bschulz1701/LEAF/Documentation/LEAF_v2_BlockDiagrams.pptx

Rain Gauge

Pulse

Counter

BME280

Anemometer

Pulse

Counter

I2C/Serial

Accelerometer

Particle

Sap Flux

Analog

I2C

Stream Depth

Amp

Serial

PAR

Analog

OneWire

Stream Temp

Amp

I2C/Analog

Radiometer

Analog

Amp

## Slide 2

Solar

MPPT

Battery

Power Monitor

Particle

Vin

3.3v

Switch

Sensors
3v3

5.0v

Switch

DC/DC

Heater
PWM

Sensors
5v
