bschulz1701/LEAF/Documentation/LEAF_v2_BlockDiagrams.pdf

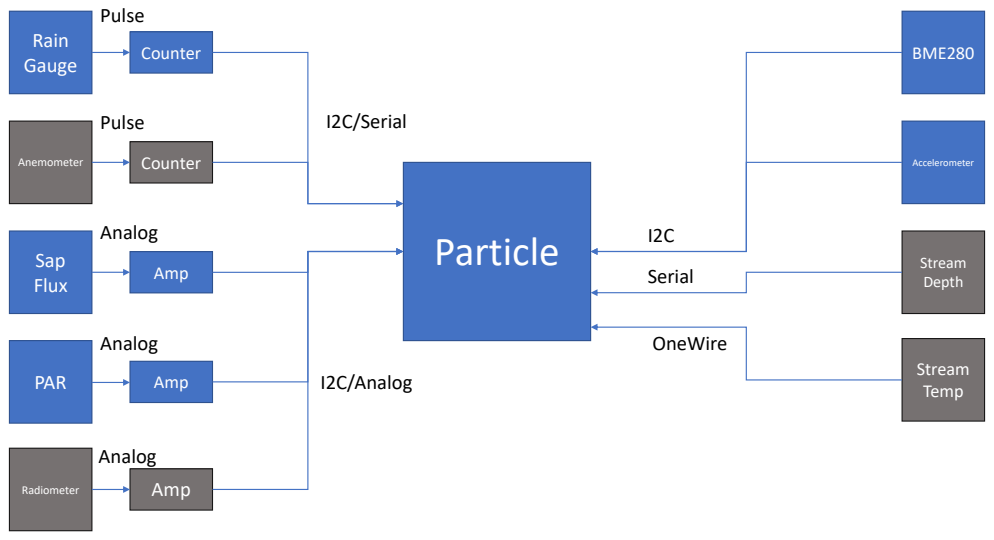
[picture p1: page 1]
Particle; Rain; Gauge; Counter; Anemometer; Sap; Flux; Amp; PAR; Radiometer; BME280; Accelerometer; Stream Depth; Stream Temp; Pulse; Analog; I2C/Analog; I2C/Serial; Serial; OneWire

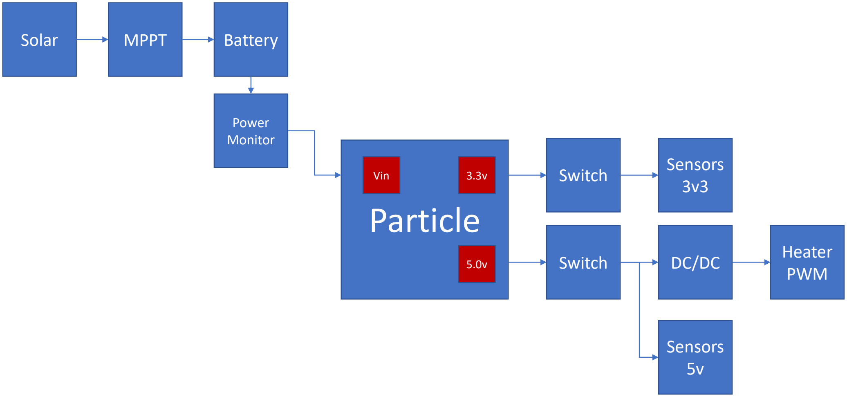
[picture p2: figure]
Particle; Vin; Solar; MPPT; Battery; Switch; Heater PWM; Sensors 5v; Sensors 3v3; Power Monitor
