bschulz1701/LEAF/Hardware/CoreLogger_TopLoadMicro.brd

## EAGLE design Hardware/CoreLogger_TopLoadMicro.brd (2019-05-06)

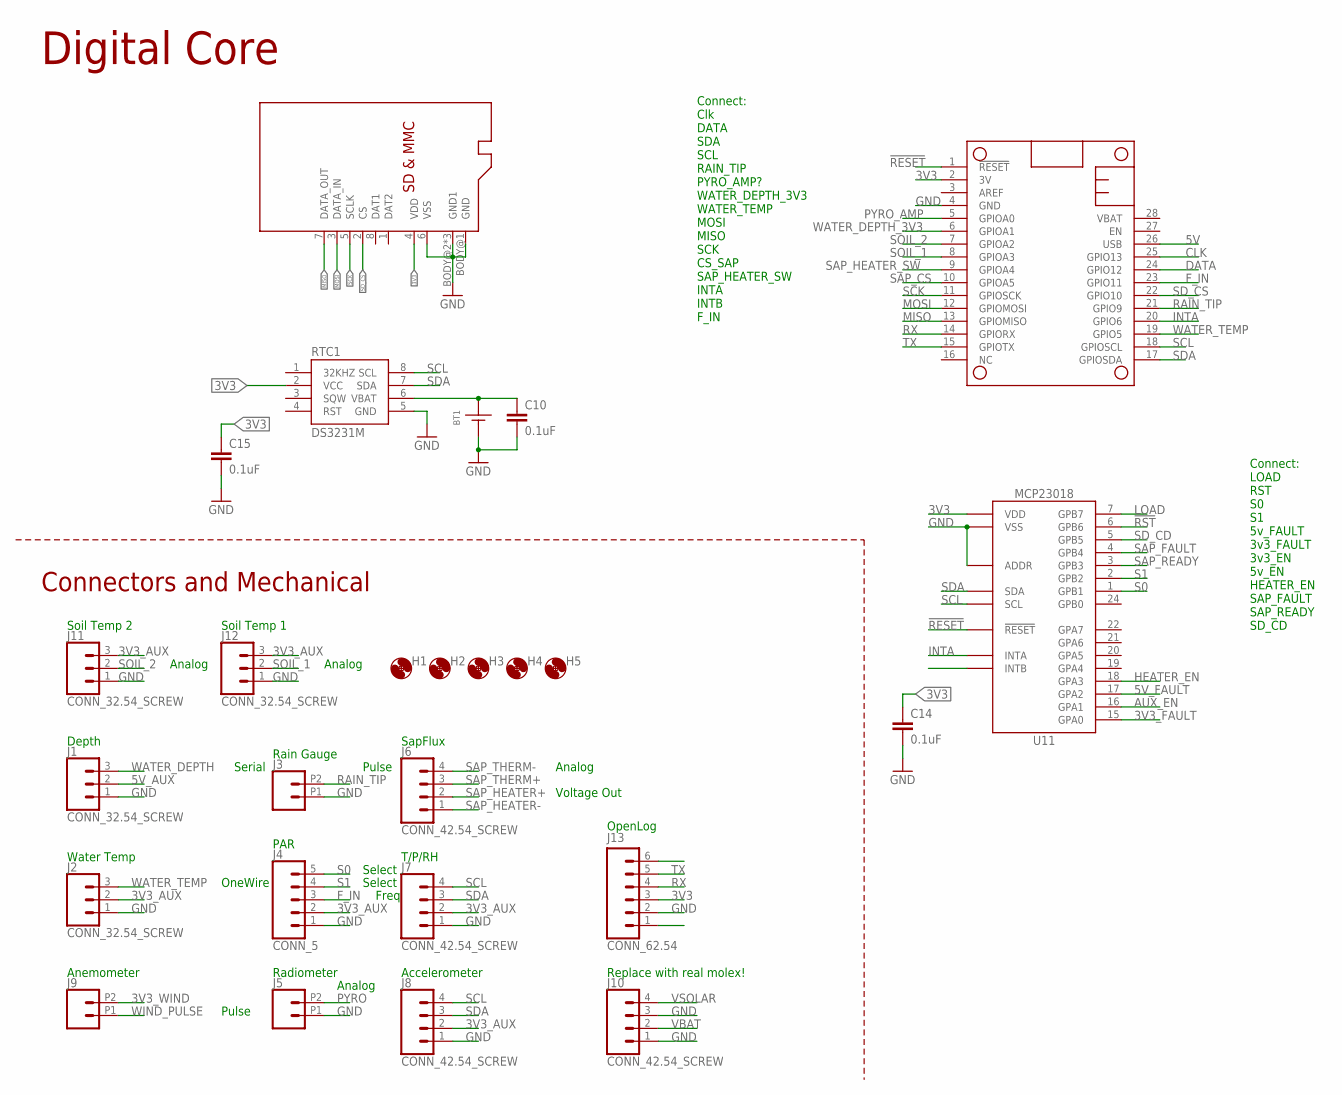
[picture p3: schematic CoreLogger_TopLoadMicro.sch, sheet 1]

Parts:
BT1: BATTERY_COIN12MM; LINX_BAT-HLD-012-SMT
C10: 0.1uF; C0603
C14, C15: 0.1uF; C0402
H1, H2, H3, H4, H5: MOUNTING_HOLE4_NP; 4_40
J1, J2, J11, J12: CONN_32.54_SCREW; 1X03_SCREW
J3, J5, J9: CONN_022.54_SCREW; 1X02_2.54_SCREWTERM
J4: CONN_5; 1X05
J6, J7, J8, J10: CONN_42.54_SCREW; 1X04_SCREW
J13: CONN_62.54; 1X06
MS1: FEATHERWING_NODIM; FEATHERWING_DIM
RTC1: DS3231M; SO08
SD1: MICROSD_NOCDHINDGED; USD_MOLEX_HINDGED
U11: MCP23018QFN; QFN24

Connections:
3V3: C14.1, C15.1, J13.3, MS1.2 (3V), RTC1.2 (VCC), SD1.4 (VDD), U11.8 (VDD); also elsewhere on the board
3V3_AUX: J2.2, J4.2, J7.2, J8.2, J11.3, J12.3; also elsewhere on the board
3V3_FAULT: U11.15 (GPA0); also elsewhere on the board
3V3_WIND: J9.P2 (2); also elsewhere on the board
5V: MS1.26 (USB); also elsewhere on the board
5V_AUX: J1.2; also elsewhere on the board
5V_FAULT: U11.17 (GPA2); also elsewhere on the board
!RESET: MS1.1 (!RESET), U11.12 (!RESET)
!RST: U11.6 (GPB6); also elsewhere on the board
AUX_EN: U11.16 (GPA1); also elsewhere on the board
CLK: MS1.25 (GPIO13); also elsewhere on the board
DATA: MS1.24 (GPIO12); also elsewhere on the board
F_IN: J4.3, MS1.23 (GPIO11)
GND: BT1.GND (-), C10.2, C14.2, C15.2, J1.1, J2.1, J3.P1 (1), J4.1, J5.P1 (1), J7.1, J8.1, J10.1, J10.3, J11.1, J12.1, J13.2, MS1.4 (GND), RTC1.5 (GND), SD1.6 (VSS), SD1.BODY@1 (GND), SD1.BODY@2 (GND1), SD1.BODY@3 (GND1), SD1.BODY@4 (GND1), U11.11 (ADDR), U11.23 (VSS); also elsewhere on the board
HEATER_EN: U11.18 (GPA3); also elsewhere on the board
INTA: MS1.20 (GPIO6), U11.14 (INTA)
LOAD: U11.7 (GPB7); also elsewhere on the board
MISO: MS1.13 (GPIOMISO), SD1.7 (DATA_OUT); also elsewhere on the board
MOSI: MS1.12 (GPIOMOSI), SD1.3 (DATA_IN); also elsewhere on the board
unnamed: BT1.POWER0 (+), BT1.POWER1 (+), C10.1, RTC1.6 (VBAT)
PYRO: J5.P2 (2); also elsewhere on the board
PYRO_AMP: MS1.5 (GPIOA0); also elsewhere on the board
RAIN_TIP: J3.P2 (2), MS1.21 (GPIO9); also elsewhere on the board
RX: J13.4, MS1.14 (GPIORX)
S0: J4.5, U11.1 (GPB1)
S1: J4.4, U11.2 (GPB2)
SAP_CS: MS1.10 (GPIOA5); also elsewhere on the board
SAP_FAULT: U11.4 (GPB4); also elsewhere on the board
SAP_HEATER+: J6.2; also elsewhere on the board
SAP_HEATER-: J6.1; also elsewhere on the board
SAP_HEATER_SW: MS1.9 (GPIOA4); also elsewhere on the board
SAP_READY: U11.3 (GPB3); also elsewhere on the board
SAP_THERM+: J6.3; also elsewhere on the board
SAP_THERM-: J6.4; also elsewhere on the board
SCK: MS1.11 (GPIOSCK), SD1.5 (SCLK); also elsewhere on the board
SCL: J7.4, J8.4, MS1.18 (GPIOSCL), RTC1.8 (SCL), U11.9 (SCL); also elsewhere on the board
SDA: J7.3, J8.3, MS1.17 (GPIOSDA), RTC1.7 (SDA), U11.10 (SDA); also elsewhere on the board
SD_CD: U11.5 (GPB5)
SD_CS: MS1.22 (GPIO10), SD1.2 (CS)
SOIL_1: J12.2, MS1.8 (GPIOA3)
SOIL_2: J11.2, MS1.7 (GPIOA2)
TX: J13.5, MS1.15 (GPIOTX)
VBAT: J10.2; also elsewhere on the board
VSOLAR: J10.4; also elsewhere on the board
WATER_DEPTH: J1.3; also elsewhere on the board
WATER_DEPTH_3V3: MS1.6 (GPIOA1); also elsewhere on the board
WATER_TEMP: J2.3, MS1.19 (GPIO5); also elsewhere on the board
WIND_PULSE: J9.P1 (1); also elsewhere on the board

Notes on the sheet:
Depth
Water Temp
Radiometer
PAR
Rain Gauge
Accelerometer
T/P/RH
SapFlux
OneWire
Serial
Pulse
Freq
Select
Analog
Voltage Out
Anemometer
Replace with real molex!
Connect: Clk DATA SDA SCL RAIN_TIP PYRO_AMP? WATER_DEPTH_3V3 WATER_TEMP MOSI MISO SCK CS_SAP SAP_HEATER_SW INTA INTB F_IN
Connect: LOAD RST S0 S1 5v_FAULT 3v3_FAULT 3v3_EN 5v_EN HEATER_EN SAP_FAULT SAP_READY SD_CD
Digital Core
Connectors and Mechanical
Soil Temp 2
Soil Temp 1
OpenLog

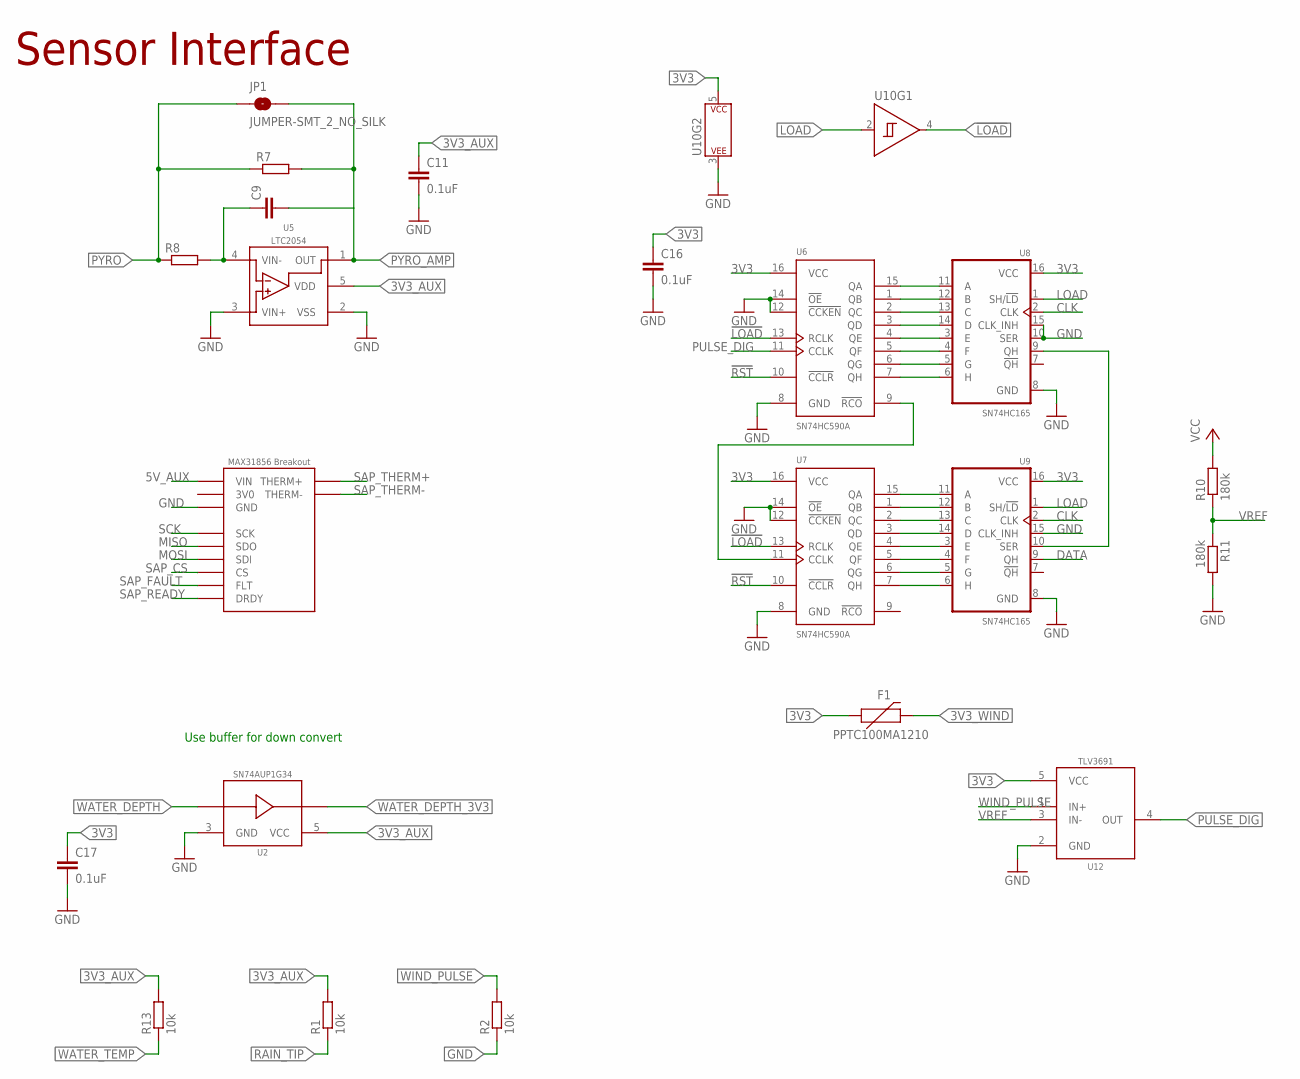
[picture p4: schematic CoreLogger_TopLoadMicro.sch, sheet 2]

Parts:
C9: C-EU1NFC0603; C0603
C11, C16, C17: 0.1uF; C0402
F1: PPTC100MA1210; 1210_BOURNS
JP1: JUMPER-SMT_2_NO_SILK; SMT-JUMPER_2_NO_SILK
R1, R2, R13: 10k; R0603
R7: R-EU_P27KR0603; R0603
R8: R-EU_1KR0603; R0603
R10, R11: 180k; R0603
U2: SN74AUP1G34SC70; DCK_R-PDSO-G5
U5: LTC2054; SOT23-5
U6, U7: SN74HC590AD; SO16
U8, U9: SN74HC165D; SO16
U10: SN74AUP1G14DCK; DCK_R-PDSO-G5
U12: TLV3691DCK; DCK_R-PDSO-G5
XU1: MAX31856_BREAKOUT

Connections:
3V0: XU1.3VO (3V0)
3V3: C16.1, C17.1, F1.1, R10.2, U6.16 (VCC), U7.16 (VCC), U8.16 (VCC), U9.16 (VCC), U10.5 (P$V+), U12.5 (VCC); also elsewhere on the board
3V3_AUX: C11.1, R1.2, R13.2, U2.5 (VCC), U5.5 (VDD); also elsewhere on the board
3V3_WIND: F1.2; also elsewhere on the board
5V_AUX: XU1.VIN; also elsewhere on the board
!LOAD: U6.13 (RCLK), U7.13 (RCLK), U10.4 (Y)
!RST: U6.10 (!CCLR), U7.10 (!CCLR); also elsewhere on the board
CLK: U8.2 (CLK), U9.2 (CLK); also elsewhere on the board
DATA: U9.9 (QH); also elsewhere on the board
GND: C11.2, C16.2, C17.2, R2.1, R11.2, U2.3 (GND), U5.2 (VSS), U5.3 (VIN+), U6.8 (GND), U6.12 (!CCKEN), U6.14 (!OE), U7.8 (GND), U7.12 (!CCKEN), U7.14 (!OE), U8.8 (GND), U8.10 (SER), U8.15 (CLK_INH), U9.8 (GND), U9.15 (CLK_INH), U10.3 (P$V-), U12.2 (GND), XU1.GND; also elsewhere on the board
LOAD: U8.1 (SH/!LD), U9.1 (SH/!LD), U10.2 (A); also elsewhere on the board
MISO: XU1.SDO; also elsewhere on the board
MOSI: XU1.SDI; also elsewhere on the board
unnamed: C9.1, R8.2, U5.4 (VIN-)
unnamed: U7.15 (QA), U9.11 (A)
unnamed: U7.1 (QB), U9.12 (B)
unnamed: U7.2 (QC), U9.13 (C)
unnamed: U7.3 (QD), U9.14 (D)
unnamed: U7.4 (QE), U9.3 (E)
unnamed: U7.5 (QF), U9.4 (F)
unnamed: U7.6 (QG), U9.5 (G)
unnamed: U7.7 (QH), U9.6 (H)
unnamed: U6.7 (QH), U8.6 (H)
unnamed: U6.6 (QG), U8.5 (G)
unnamed: U6.5 (QF), U8.4 (F)
unnamed: U6.4 (QE), U8.3 (E)
unnamed: U6.3 (QD), U8.14 (D)
unnamed: U6.2 (QC), U8.13 (C)
unnamed: U6.1 (QB), U8.12 (B)
unnamed: U6.15 (QA), U8.11 (A)
unnamed: U8.9 (QH), U9.10 (SER)
unnamed: U6.9 (!RCO), U7.11 (CCLK)
PULSE_DIG: U6.11 (CCLK), U12.4 (OUT)
PYRO: JP1.1, R7.1, R8.1; also elsewhere on the board
PYRO_AMP: C9.2, JP1.2, R7.2, U5.1 (OUT); also elsewhere on the board
RAIN_TIP: R1.1; also elsewhere on the board
SAP_CS: XU1.CS; also elsewhere on the board
SAP_FAULT: XU1.FLT; also elsewhere on the board
SAP_READY: XU1.DRDY; also elsewhere on the board
SAP_THERM+: XU1.THERM+; also elsewhere on the board
SAP_THERM-: XU1.THERM-; also elsewhere on the board
SCK: XU1.SCK; also elsewhere on the board
VREF: R10.1, R11.1, U12.3 (IN-)
WATER_DEPTH: U2.2 (A); also elsewhere on the board
WATER_DEPTH_3V3: U2.4 (Y); also elsewhere on the board
WATER_TEMP: R13.1; also elsewhere on the board
WIND_PULSE: R2.2, U12.1 (IN+); also elsewhere on the board

Notes on the sheet:
Use buffer for down convert
Sensor Interface

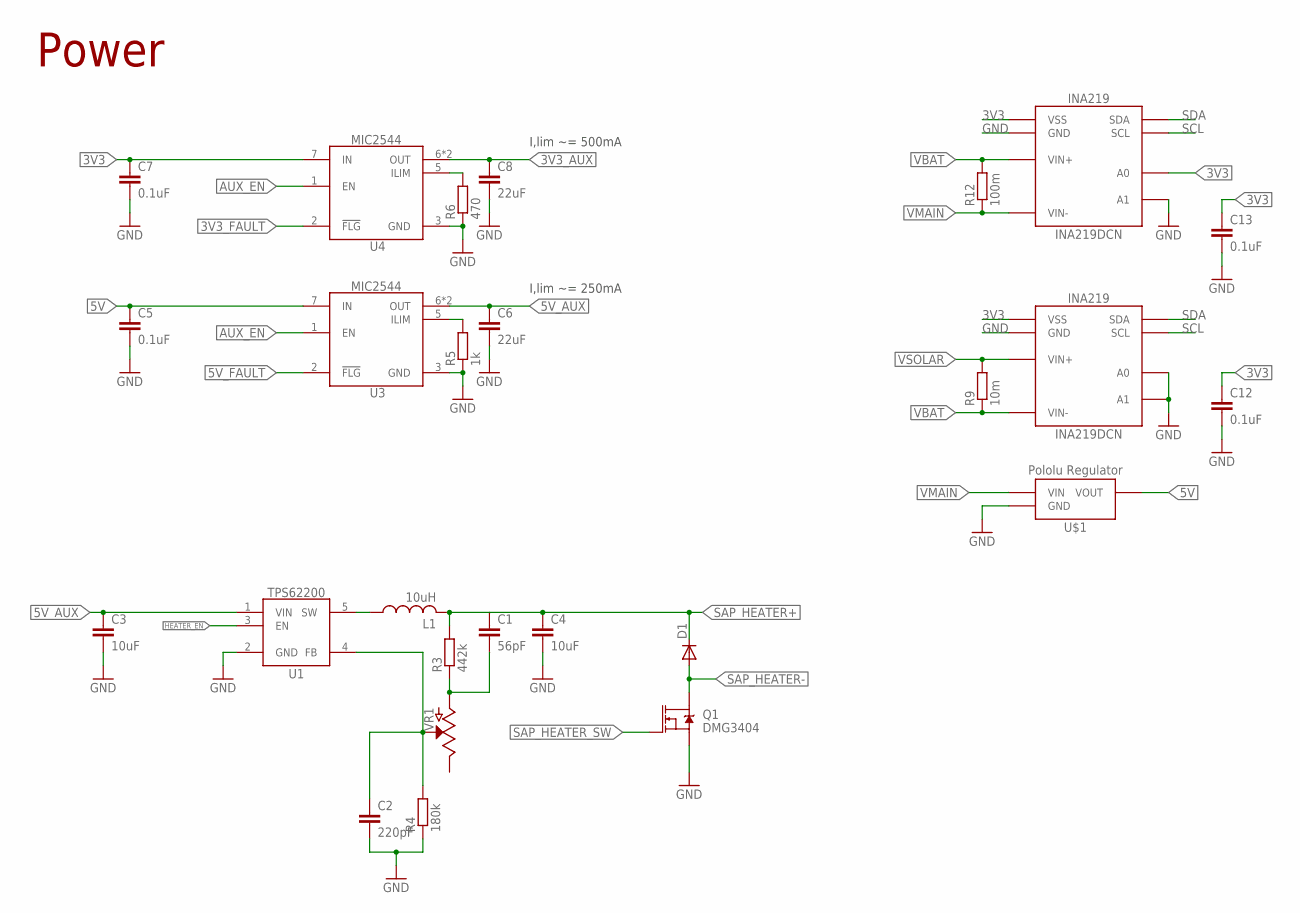
[picture p5: schematic CoreLogger_TopLoadMicro.sch, sheet 3]

Parts:
C1: 56pF; C0402
C2: 220pF; C0402
C3, C4: 10uF; C0805
C5, C7, C12, C13: 0.1uF; C0402
C6, C8: 22uF; C0805
D1: DIODESOD-123; SOD-123; MPN 1N4448W-TP; DIGIKEY 1N4448WTPMSCT-ND
L1: 10uH; WE-LQS(4X4); MPN 74404043100A; DIGIKEY 732-10757-1-ND
Q1: DMG3404; SOT23-3
R3: 442k; R0603
R4: 180k; R0603
R5: 1k; R0603
R6: 470; R0603
R9: 10m; R0805
R12: 100m; R0805
U1: TPS62200SOT23; DBV0005A
U3, U4: MIC2544MSOP; MSOP_8
U13, U14: INA219DCN; DCN_R-PDSO-G8
U$1: POLOLU_REGULATOR; U1V10FX_REGULATOR
VR1: POTENTIOMETER3214W; POT_3214W; MPN 3214W-1-204E; DIGIKEY 3214W-1-204ECT-ND

Connections:
3V3: C7.1, C12.1, C13.1, U4.7 (IN), U13.4 (VSS), U14.4 (VSS), U14.7 (A0); also elsewhere on the board
3V3_AUX: C8.1, U4.6 (OUT), U4.8 (OUT); also elsewhere on the board
3V3_FAULT: U4.2 (!FLG); also elsewhere on the board
5V: C5.1, U3.7 (IN), U$1.VOUT; also elsewhere on the board
5V_AUX: C3.1, C6.1, U1.1 (VIN), U3.6 (OUT), U3.8 (OUT); also elsewhere on the board
5V_FAULT: U3.2 (!FLG); also elsewhere on the board
AUX_EN: U3.1 (EN), U4.1 (EN); also elsewhere on the board
GND: C2.2, C3.2, C4.2, C5.2, C6.2, C7.2, C8.2, C12.2, C13.2, Q1.2 (S), R4.1, R5.1, R6.1, U1.2 (GND), U3.3 (GND), U4.3 (GND), U13.3 (GND), U13.7 (A0), U13.8 (A1), U14.3 (GND), U14.8 (A1), U$1.GND; also elsewhere on the board
HEATER_EN: U1.3 (EN); also elsewhere on the board
unnamed: C1.2, R3.1, VR1.1 (A)
unnamed: C2.1, R4.2, U1.4 (FB), VR1.2 (S)
unnamed: R6.2, U4.5 (ILIM)
unnamed: R5.2, U3.5 (ILIM)
unnamed: L1.P$1 (1), U1.5 (SW)
SAP_HEATER+: C1.1, C4.1, D1.CAT (C), L1.P$2 (2), R3.2; also elsewhere on the board
SAP_HEATER-: D1.ANODE (A), Q1.3 (D); also elsewhere on the board
SAP_HEATER_SW: Q1.1 (G); also elsewhere on the board
SCL: U13.5 (SCL), U14.5 (SCL); also elsewhere on the board
SDA: U13.6 (SDA), U14.6 (SDA); also elsewhere on the board
VBAT: R9.1, R12.2, U13.2 (VIN-), U14.1 (VIN+); also elsewhere on the board
VMAIN: R12.1, U14.2 (VIN-), U$1.VIN
VSOLAR: R9.2, U13.1 (VIN+); also elsewhere on the board

Notes on the sheet:
Power
I,lim ~= 500mA
I,lim ~= 250mA

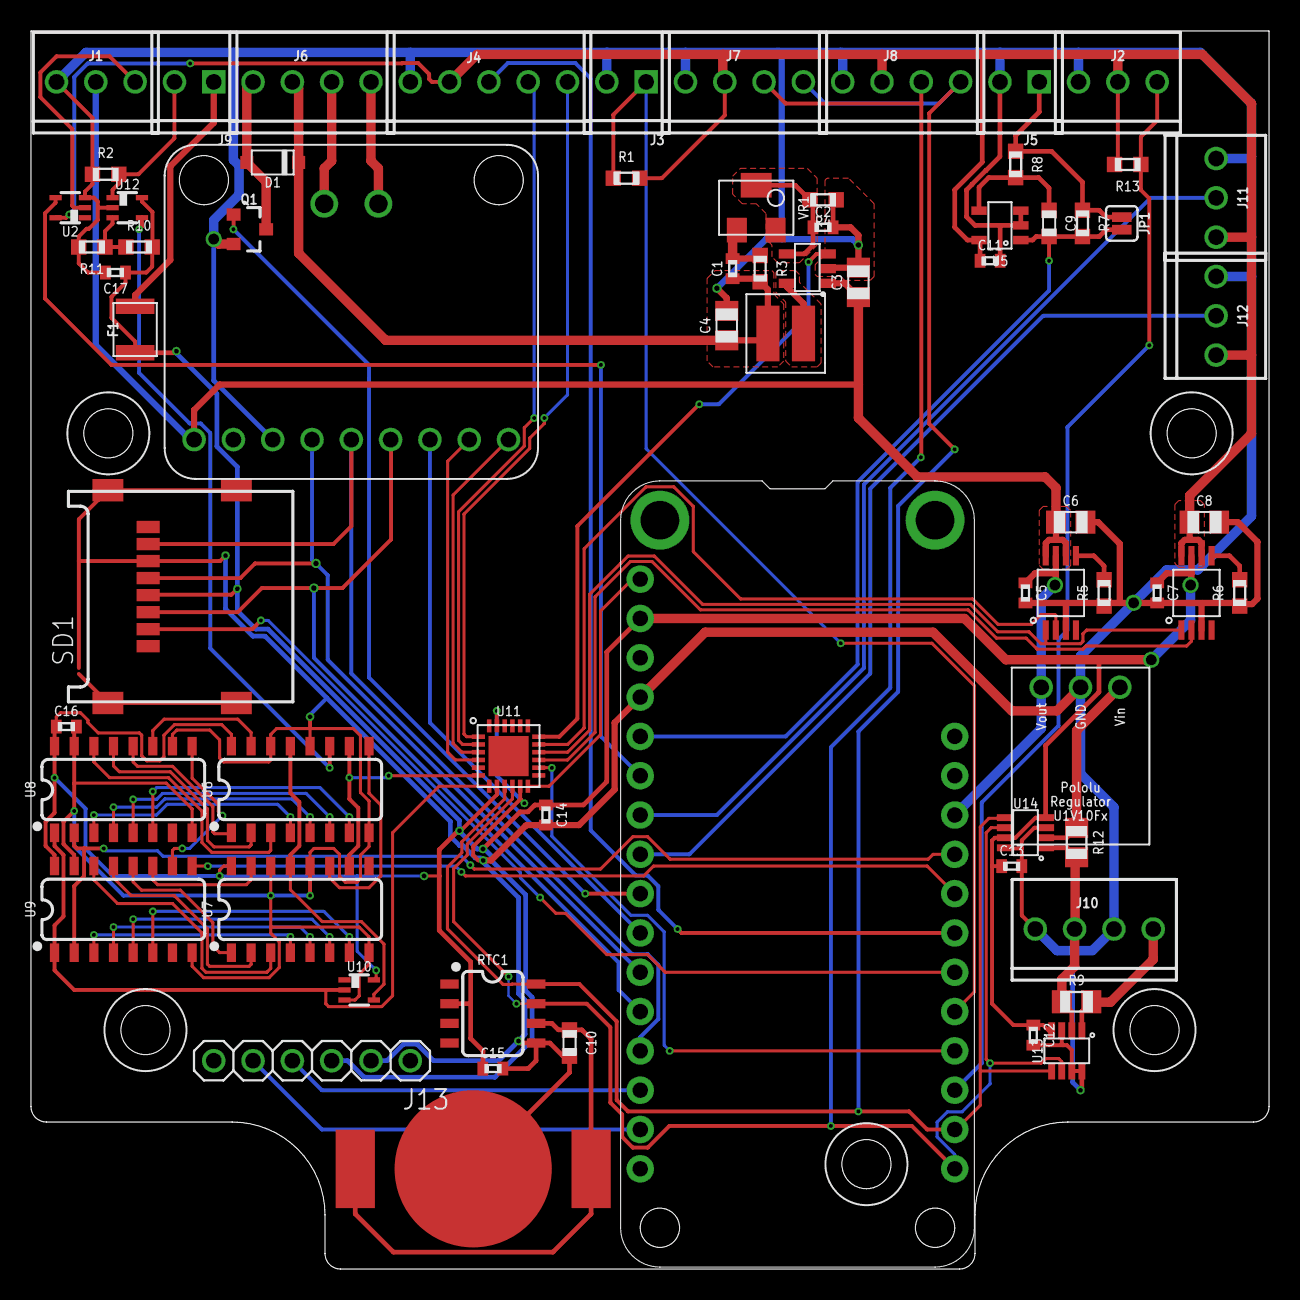
[picture p6: board CoreLogger_TopLoadMicro.brd from above]

Board: 2 copper layers, 80.0 x 80.0 mm, 74 parts (0 on the bottom side), 75 nets.
