bschulz1701/LEAF/Hardware/SolarTest/SolarMonitor_Pro.brd

## EAGLE design Hardware/SolarTest/SolarMonitor_Pro.brd (2019-03-21)

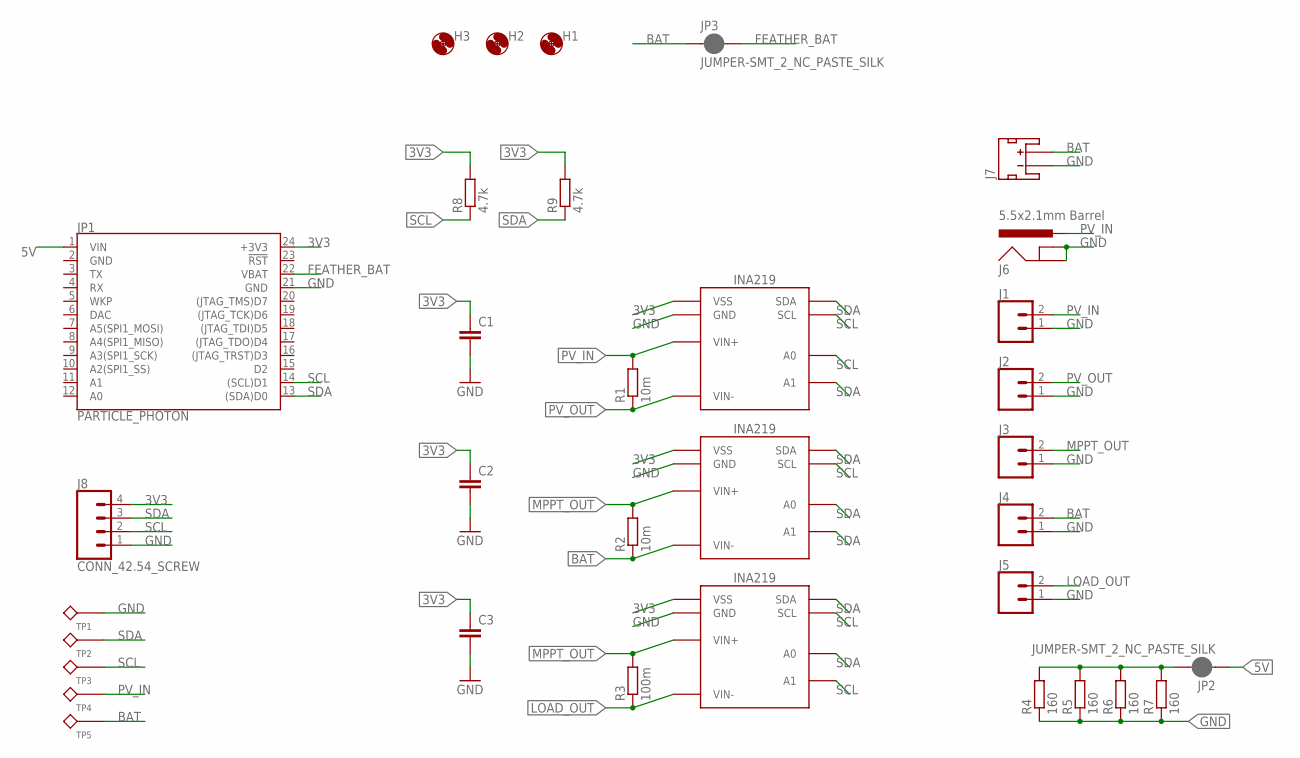
[picture p7: schematic SolarMonitor_Pro.sch]

Parts:
C1, C2, C3: C-EU0.1UFC0402; C0402
H1, H2, H3: MOUNTING_HOLE4_NP; 4_40
J1, J2, J3, J4, J5: CONN_023.5MM; SCREWTERMINAL-3.5MM-2
J6: 5.5x2.1mm Barrel; POWER_JACK_SMD
J7: JST_2MM_MALE; JST-2-SMD
J8: CONN_42.54_SCREW; 1X04_SCREW
JP1: PARTICLE_PHOTON
JP2, JP3: JUMPER-SMT_2_NC_PASTE_SILK; SMT-JUMPER_2_NC_PASTE_SILK
R1, R2: 10m; R0805
R3: 100m; R0805
R4, R5, R6, R7: 160; R1206
R8, R9: 4.7k; R0402
TP1, TP2, TP3, TP4, TP5: TESTPOINTRCU; TESTPOINT_0603
U1, U2, U3: INA219DCN; DCN_R-PDSO-G8

Connections:
3V3: C1.1, C2.1, C3.1, J8.4, JP1.24 (+3V3), R8.2, R9.2, U1.4 (VSS), U2.4 (VSS), U3.4 (VSS)
5V: JP1.1 (VIN), JP2.1
BAT: J4.2, J7.2 (+), JP3.1, R2.1, TP5.1, U2.2 (VIN-)
FEATHER_BAT: JP1.22 (VBAT), JP3.2
GND: C1.2, C2.2, C3.2, J1.1, J2.1, J3.1, J4.1, J5.1, J6.GND (GNDBREAK), J6.P$4 (GND), J7.1 (-), J8.1, JP1.2 (GND), JP1.21 (GND), R4.1, R5.1, R6.1, R7.1, TP1.1, U1.3 (GND), U2.3 (GND), U3.3 (GND)
LOAD: JP2.2, R4.2, R5.2, R6.2, R7.2
LOAD_OUT: J5.2, R3.1, U3.2 (VIN-)
MPPT_OUT: J3.2, R2.2, R3.2, U2.1 (VIN+), U3.1 (VIN+)
PV_IN: J1.2, J6.VIN0 (PWR), R1.2, TP4.1, U1.1 (VIN+)
PV_OUT: J2.2, R1.1, U1.2 (VIN-)
SCL: J8.2, JP1.14 ((SCL)D1), R8.1, TP3.1, U1.5 (SCL), U1.7 (A0), U2.5 (SCL), U3.5 (SCL), U3.8 (A1)
SDA: J8.3, JP1.13 ((SDA)D0), R9.1, TP2.1, U1.6 (SDA), U1.8 (A1), U2.6 (SDA), U2.7 (A0), U2.8 (A1), U3.6 (SDA), U3.7 (A0)

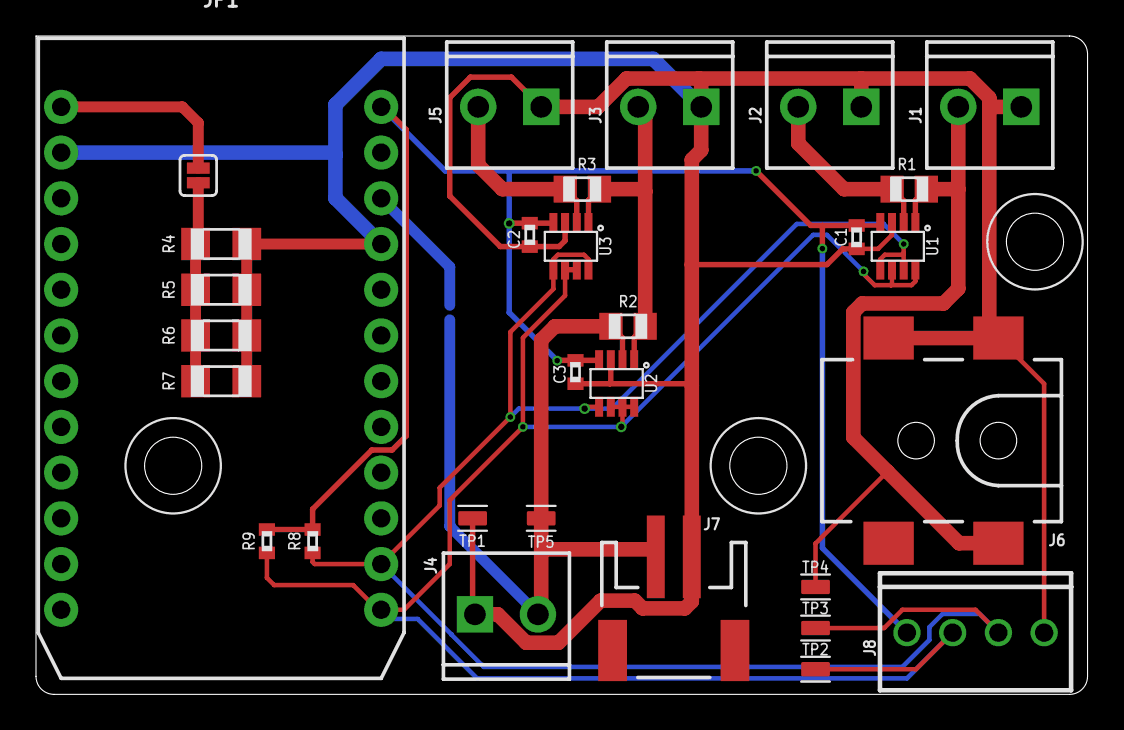
[picture p8: board SolarMonitor_Pro.brd from above]

Board: 2 copper layers, 58.4 x 36.6 mm, 34 parts (1 on the bottom side), 12 nets.
