bschulz1701/LEAF/Hardware/SolarTest/SolarMonitor.brd

## EAGLE design Hardware/SolarTest/SolarMonitor.brd (2019-03-18)

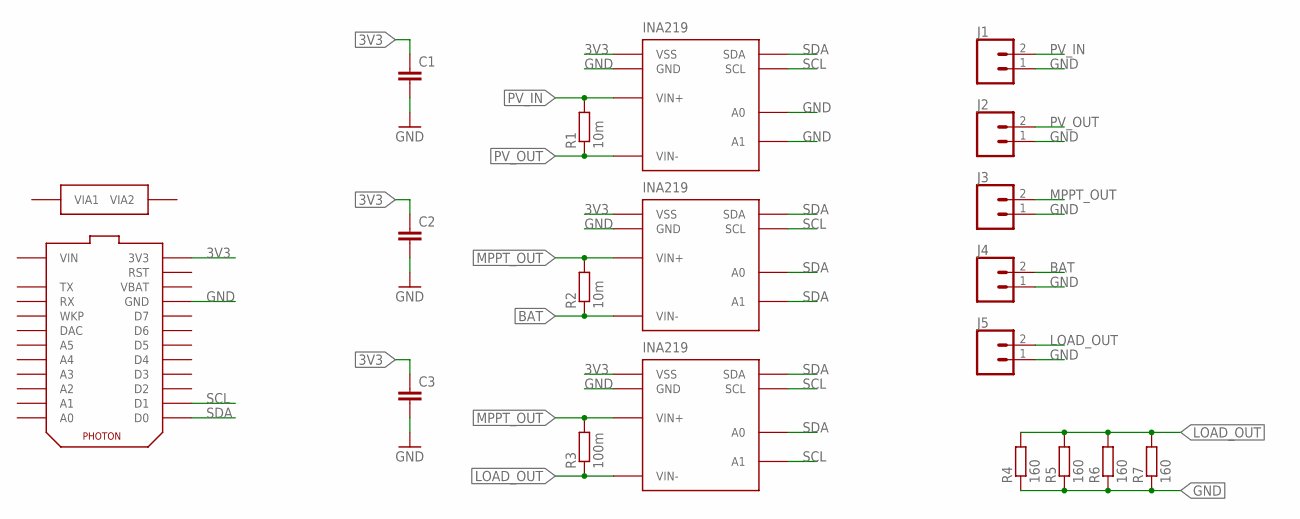
[picture p9: schematic SolarMonitor.sch]

Parts:
C1, C2, C3: C-EU0.1UFC0603; C0603
J1, J2, J3, J4, J5: CONN_023.5MM; SCREWTERMINAL-3.5MM-2
R1, R2: 10m; R0805
R3: 100m; R0805
R4, R5, R6, R7: 160; R1206
U$1: TEMPLATE_PHOTON_RAW; PHOTON_RAW
U$2, U$3, U$4: INA219; SOIC_8

Connections:
3V3: C1.1, C2.1, C3.1, U$1.3V3, U$1.3V3. (3V3), U$1.3V31 (3V3), U$2.5 (VSS), U$3.5 (VSS), U$4.5 (VSS)
BAT: J4.2, R2.1, U$3.7 (VIN-)
GND: C1.2, C2.2, C3.2, J1.1, J2.1, J3.1, J4.1, J5.1, R4.1, R5.1, R6.1, R7.1, U$1.GND, U$1.GND1 (GND), U$1.GND. (GND), U$1.GND.@1 (GND), U$1.GND@1 (GND), U$1.GND@2 (GND), U$2.1 (A1), U$2.2 (A0), U$2.6 (GND), U$3.6 (GND), U$4.6 (GND)
LOAD_OUT: J5.2, R3.1, R4.2, R5.2, R6.2, R7.2, U$4.7 (VIN-)
MPPT_OUT: J3.2, R2.2, R3.2, U$3.8 (VIN+), U$4.8 (VIN+)
PV_IN: J1.2, R1.2, U$2.8 (VIN+)
PV_OUT: J2.2, R1.1, U$2.7 (VIN-)
SCL: U$1.D1, U$1.D1. (D1), U$1.D1@1 (D1), U$2.4 (SCL), U$3.4 (SCL), U$4.1 (A1), U$4.4 (SCL)
SDA: U$1.D0, U$1.D0. (D0), U$1.D0@1 (D0), U$2.3 (SDA), U$3.1 (A1), U$3.2 (A0), U$3.3 (SDA), U$4.2 (A0), U$4.3 (SDA)

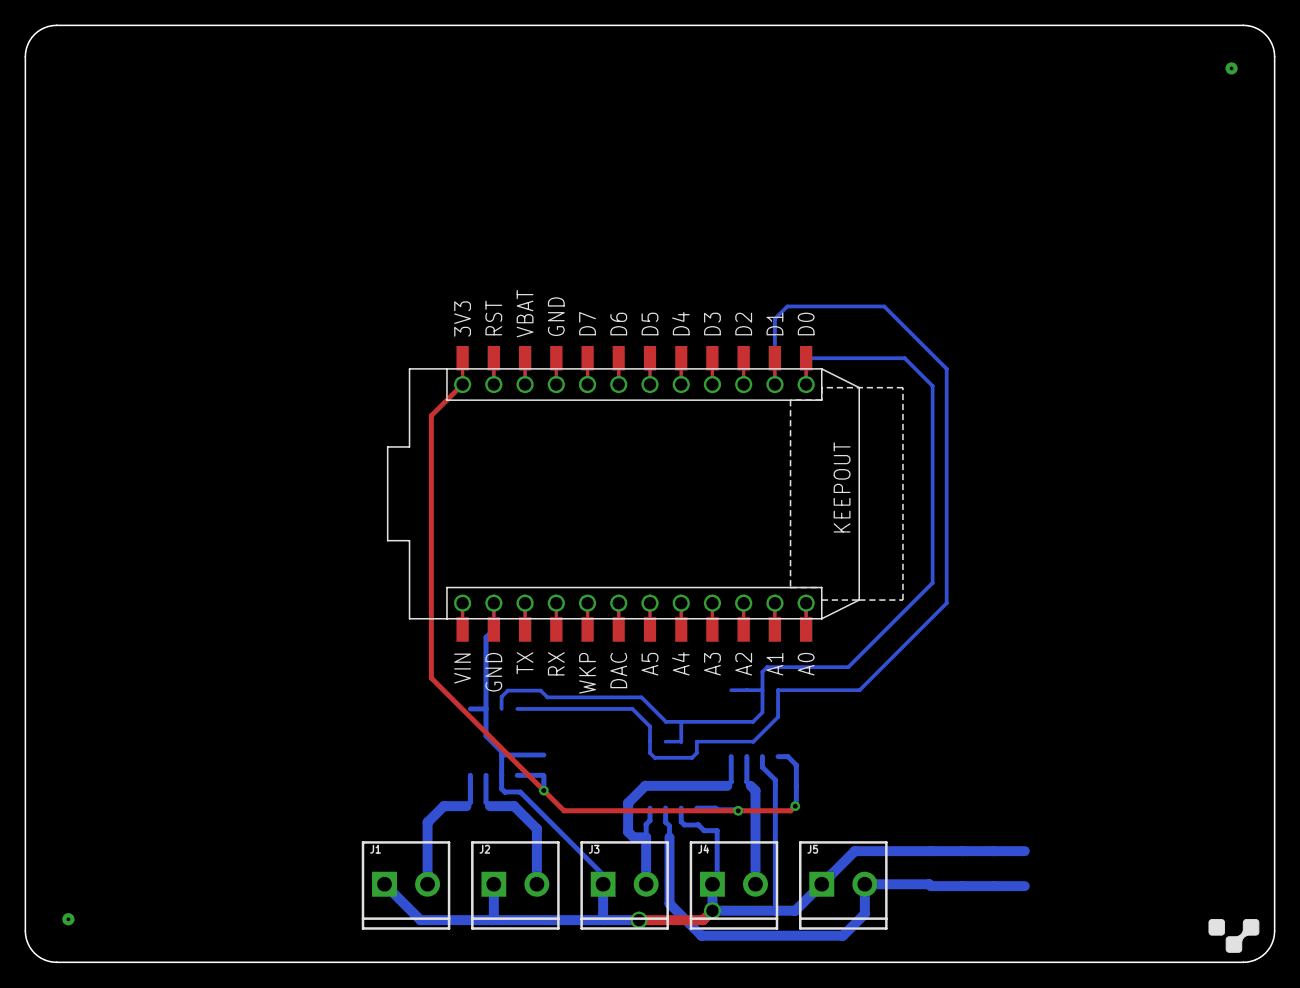
[picture p10: board SolarMonitor.brd from above]

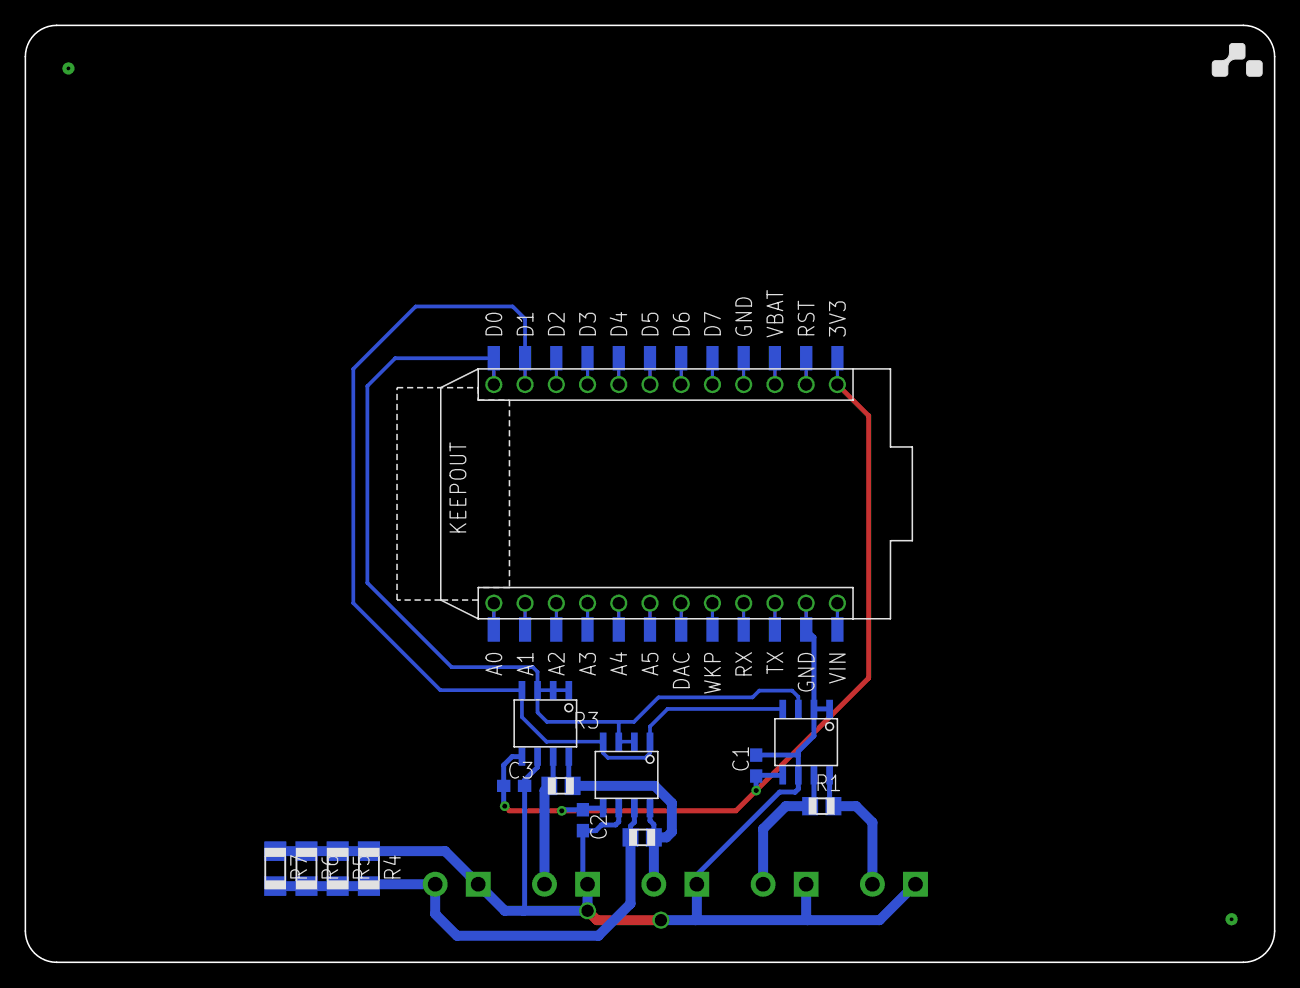
[picture p11: board SolarMonitor.brd from below]

Board: 2 copper layers, 101.6 x 76.2 mm, 19 parts (13 on the bottom side), 9 nets.
