bschulz1701/LEAF/(commit log)

2019-03-18 Added initial design for Solar Measurement system
    Added v0 design for solar measurement prototype
    [SolarMonitor.brd, SolarMonitor.sch]
2019-03-18 Added Voltera compatible gerbers
    [copper_bottom.GBL, copper_top.GTL, profile.GKO, silkscreen_bottom.GBO, silkscreen_top.GTO, soldermask_bottom.GBS, soldermask_top.GTS, solderpaste_bottom.GBP]
2019-03-19 Added Solar Monitor layout for external mfg
    Added Solar Monitor for OSH Park Manufacture, final layout required
    [SolarMonitor_Pro.brd, SolarMonitor_Pro.sch]
2019-03-19 Updated solar monitor board, v0 ready for fab
    [SolarMonitor_Pro.brd, SolarMonitor_Pro.sch]
2019-03-21 Final cleanup/part number for solar monitor v0
    [SolarMonitor_Pro.brd, SolarMonitor_Pro.sch]
2019-04-19 Added ALPHA design for core logger
    Added very preliminary schematic design for core data logger, significant additions needed
    [CoreLogger.sch]
2019-04-21 Added Eagle library, continued logger designs
    [CoreLogger.brd, CoreLogger.sch]
2019-04-21 Routing and minor design updates
    The majority of functionality is present, passes DRC, need to add polygons and test points, along with labeling
    [CoreLogger.brd, CoreLogger.sch]
2019-04-22 Further updates, ready for final review
    Added silkscreen and minor layout improvements
    [CoreLogger.brd, CoreLogger.sch]
2019-04-22 Generated optional board designs, generated gerbers
    [CoreLogger_TopLoadMicro.brd, CoreLogger_TopLoadMicro.sch, CoreLogger_TopLoadMicro_CD.brd, CoreLogger_TopLoadMicro_CD.sch]
2019-04-23 Added BoM info and software for Lidar Lite interface
    Updated the BoM information in Eagle and generated csv, also added software for LidarLite interface system
    [CoreLogger_BOM.csv, CoreLogger_TopLoadMicro.brd, CoreLogger_TopLoadMicro.sch]
2019-04-25 Updated LidarLite code
    Improved Lidar lite code to reduce power consumption and improve stability
    [LidarLiteV3_Intermediate.ino]
2019-04-26 General schematic cleanup on logger board
    [CoreLogger_TopLoadMicro.brd, CoreLogger_TopLoadMicro.sch]
2019-05-06 Minor cleanup
    [CoreLogger_TopLoadMicro.brd, CoreLogger_TopLoadMicro.sch]
