bschulz1701/LEAF/(notices)

Notices in the files:
parts and their libraries:
SparkFun-Jumpers: Licensing: Creative Commons ShareAlike 4.0 International - https://creativecommons.org/licenses/by-sa/4.0
bschulz: This work is licensed under the Creative Commons Attribution-ShareAlike 4.0
http://creativecommons.org/licenses/by-sa/4.0
